laurb9/PanoController-Firmware/(threads)

Thread 1 (2016-03-05):

clean up pano interruption mode

laurb9, 2016-03-05:
- [x]  next/prev works well
- [x]  need a clean way to continue/end pano
  (right now OK ends and there is no way to continue)
- [x] should have a clearer display indicating which button does what

laurb9, 2016-03-06:
commit fe49507 partially implemented but still needs work

laurb9, 2016-03-07:
With IR remote, one can use OK to continue or cancel.

Closed 2016-03-07.

Thread 10 (2016-03-05):

Bluetooth 4.1 support

laurb9, 2016-03-05:
Same as (or depending on #8) but would need iOS app to control.

Major advantage would be that we can manage many pano profiles and pre-generate stitch files with photos already in position. The pano execution can be GPS-tagged and timestamped and used to identify the photo set once downloaded to the PC. Then we need a tool to preorder the images.

laurb9, 2016-04-03:
This could help: https://www.raywenderlich.com/85900/arduino-tutorial-integrating-bluetooth-le-ios-swift

laurb9, 2016-04-03:
Identified candidate board: HM-10 or HM-11, Bluetooth 4.0 LE
http://www.openhwdesign.com/ble-hm-10/
http://www.banggood.com/HM-10-Bluetooth-4_0-Module-Transparent-Serial-Port-p-967059.html

laurb9, 2016-07-24:
Another option is the Feather M0 BLE from Adafruit. Cortex M0 plus Bluetooth 4.1 LE in a pro-mini form factor.
https://learn.adafruit.com/adafruit-feather-m0-bluefruit-le/overview

Also Arduino 101 with Curie/Bluetooth, same price but large form factor.
Advantage: includes an IMU so one less board to connect to.
http://store-usa.arduino.cc/collections/products-atheart/products/abx00005

laurb9, 2016-08-08:
#59

laurb9, 2016-08-13:
Implemented a simple bluetooth control using the generic Adafruit Bluefruit iOS App
Connect to "Adafruit Bluefruit LE" -> Controller tab -> Control Pad module.
Directional arrows work, 1=OK, 3=CANCEL.

This is mostly a proof of concept and not all that useful yet, until all navigation can be moved to the app.

laurb9, 2017-08-14:
Work started on the [iOS PanoController App](https://github.com/laurb9/PanoController)
Will use Adafruit BLE modules because I have them already, although their interface is not compatible with the BLEPeripheral Arduino library.

This will replace the nrf24 radio controller unit that I added in #9

Closed 2017-09-11.

Thread 11 (2016-03-05):

Zero-motion shutter delay mode (gyro-based)

laurb9, 2016-03-05:
The MPU needs to be installed on camera platform, not base - need vertical flex wiring
Adds more complexity but has significant benefits:

Most important is "Shutter zero-motion wait mode": wait until platform is stable relative to the shutter and focal length selected, before activating shutter.

Closed 2016-04-01.

Thread 13 (2016-03-05):

PCB board

laurb9, 2016-03-05:
- design a smaller pano platform using the 0.5A steppers or servos, and integrated MPU into carrier.

Goals:
  - more portable: lighter, smaller)
  - thin profile: less nadir problems)
  - more battery life

Thread 14 (2016-03-05):

Investigate BDC (brushless DC) or servos instead of steppers

laurb9, 2016-03-05:
- with high reduction and gyro feedback, BDC motors can potentially be used
- needs different motor driver hardware and logic
- value is weight/size reduction

Thread 15 (2016-03-05):

Increase movement precision

laurb9, 2016-03-05:
1. Currently platform movement precision is limited by reduction ratio. We need more precision.
2. The FOV angles are stored as integers, which for longer lenses is imprecise (3 instead of 3.48, etc)

Switch the movement calculation code to floats entirely. Should be ok even with Arduino, it only adds <1K to the code.

Closed 2016-03-13.

Thread 17 (2016-03-05):

Support 16:9 and 1:1 modes

laurb9, 2016-03-05:
This can be simply an issue of calculating and adding the right FOV, or we could custom-define FOV via camera in the way that gigapan does (but is not great because it needs changing with zoom)

laurb9, 2017-10-02:
Going to cancel this, as more aspect ratios will be implemented in the App instead.

Closed 2017-10-02.

Thread 18 (2016-03-05):

Add batery voltage monitor

laurb9, 2016-03-05:
Add a simple divider to display input voltage.

laurb9, 2016-03-06:
Max voltage is 10V (the DRV8834 is 10.8V). So a divider like 47K:10K should be sufficient.

Closed 2016-03-07.

Thread 19 (2016-03-05):

Direct current control

laurb9, 2016-03-05:
Investigate ways to control Aref (and motor current) dynamically. It is currently controlled via a pot on the DRV board. Possibilities include
- break pot and use DAC + voltage divider
- use 1-2 digital pins with resistors to drain from divider and create a couple preset intermediary steps by adding resistors in parallel to GND branch of the pot.
- ?

laurb9, 2016-03-07:
Made some measurements using gigapan board, which seems to confirm this idea might make sense.
With motors on but not moving, the board draws 0.5A, but during movement this surges to 1.3A.

laurb9, 2017-10-02:
DRV8880 has current control (25, 50, 75 and 100%)

laurb9, 2017-10-02:
See #41

Closed 2017-10-02.

Thread 2 (2016-03-05):

Fix pano modes setup

laurb9, 2016-03-05:
Clean up pano options

- new pano currently needs horiz/vert FOV but configures at start (does not use preset)
- 360 pano needs vert FOV (it currently uses Vert FOV preset)
- repeat pano needs nothing (it reuses saved presets)
- maybe Horiz/Vert FOV are no longer needed in menu ?

laurb9, 2016-03-06:
Allowing horiz/vert as manual presets, they can be used with "repeat last".

Closed 2016-03-06.

Thread 5 (2016-03-05):

Auto Shutter mode (maybe never)

laurb9, 2016-03-05:
Listen to camera shutter noise (or vibration via accel). This could be useful to adapt to camera settings, but the following would need to be taken into account:

- both front and end shutters make noise
- electronic front shutter (only end shutter makes noise)
- camera profiles
- long exposure

Thread 6 (2016-03-05):

Smooth out motor movement

laurb9, 2016-03-05:
Starting the motor at full power causes it to miss step sometimes, depending on which intermediate position it was on. We should start slow and build up to max rpm, then slow back down to reduce shake.

This is a StepperDriver issue mostly likely.

laurb9, 2016-03-07:
Increasing current alleviates this problem somewhat. Horiz motor aref is now at 0.3V vs vertical at 0.2V

laurb9, 2017-06-27:
Can now use LINEAR_SPEED mode available in StepperDriver 1.1.0

Closed 2017-08-14.

Thread 7 (2016-03-05):

Remember vertical orientation

laurb9, 2016-03-05:
Vertical carrier orientation is relative to platform but as there is no end marker, calibration is not possible. Do not want to keep motors on all the time, but it may be what needs to be done.

CarriedBy6, 2022-07-15:
Might want to consider an absolute position sensor that way you don’t necessarily need end stops or homing procedures. [AS5048A](https://ams.com/as5048a) I added them to my axis and found it to be enough resolution (16,000+ positions at 360deg) even at 600mm.

laurb9, 2022-07-24:
This is a good idea, thanks. I didn't know these existed. A Hall effect or optical sensor is more cost effective if a 9-axis MPU is also installed, but this position sensor has potential.

Thread 9 (2016-03-05):

Add radio transmitter (opt)

laurb9, 2016-03-05:
- All of the display and input work could be offloaded to handheld radio remote device but the system is no longer self-contained.

laurb9, 2016-04-03:
I've identified an affordable RF board that could work: NRF24L01 2.4Ghz
http://arduino-info.wikispaces.com/Nrf24L01-2.4GHz-HowTo

Defragster, 2016-04-09:
Started at the top just seeing this - I'm using ESP8266 under Arduino with my Teensy, pretty effective - full web server support with it's own processor on par with the Teensy for under $5.

laurb9, 2016-04-09:
Some interactive features such as camera positioning would be adversely affected by WiFi latency. Others, like camera settings setup, would benefit from the nicer UI in web page. Unfortunately, I do need the interactive part more than the other, because with the camera on a pole it is hard to see what it's doing and intervene.

What I'm thinking here is move the menu and controls to a detachable remote piece. This increases the complexity and needs two microcontroller boards, but offloading the display work allows the motor controller side to do more.

laurb9, 2016-08-29:
Implemented a simple proof of concept which synchronizes inputs across two units via NRF24L01. For example, IR and Bluetooth remote inputs from one device are blindly sent to the unit containing the driver.

Syncing the display should be next.

laurb9, 2016-10-24:
Abandoned the above-mentioned proof of concept as it had to future path, and instead implemented #58 with a smart remote control unit with menus using the NRF24.

laurb9, 2016-10-24:
Bluetooth integration (#10) should be relatively easy to build on top of this.

Closed 2016-10-24.

Thread 20 (2016-03-06):

Standby Mode

laurb9, 2016-03-06:
Normal (motors off) power consumption is about 15mA.

Standby Mode should
- turn off motors (drive nSLEEP LOW)
- turn off display (this is impossible with current wiring) - maybe power display from a high current pin or ?
- put uC to sleep, wake up via button interrupt

Another way to achieve all this is to use one of these for a little extra cost:
https://www.pololu.com/product/2810 or https://www.pololu.com/product/2808 (Mini Pushbutton Power Switch)

laurb9, 2017-08-14:
About turning off motors see comment in #64

laurb9, 2017-10-02:
New versions might not need display at all. The MPU should be powered off though if not needed.
The app keeps all the info though, so maybe a power button is all we need.

Thread 22 (2016-03-06):

Add a start delay

laurb9, 2016-03-06:
Need a start delay so the platform doesn't try to move while we're still pushing the OK button. This of course would not be needed with the remote.

Closed 2016-03-06.

Thread 24 (2016-03-12):

Hangs when returning from pano setup via IR remote.

laurb9, 2016-03-12:
Canceling pano setup via IR remote ("0" button) goes back all the way to main menu then hangs.
The battery is not displayed.
No controls are responding.
Reset via battery disconnect is the only recovery option.

This may not be related to the remote per se, since canceling is not available on joystick.

laurb9, 2016-03-12:
Verified not related to remote by making positionCamera() return false (joystick OK cancels and hangs)

Closed 2016-03-13.

Thread 35 (2016-03-27):

Redesign pano operation display

laurb9, 2016-03-27:
It could be more like a camera settings page showing all important settings at a glance.
Switch to using graphics instead of text where needed.

laurb9, 2017-10-02:
low priority since the local display is now optional

laurb9, 2017-10-15:
not going to do this as all the status is going to be remote

Closed 2017-10-15.

Thread 41 (2016-04-01):

Lower current for maintaining position

laurb9, 2016-04-01:
When holding camera in place, use a lower current than when moving.

laurb9, 2016-09-14:
I was planning to do this by setting the current limiting vref using the DAC on Teensy, but the new [DRV8880](https://www.pololu.com/product/2971) driver board has a four step digital current control from 25% - 100% which means even an AVR can do it.

This board has a much better voltage range also: 6.5 to 45Vcc.

Thread 42 (2016-04-01):

Set pano dimensions by moving platform by hand

laurb9, 2016-04-01:
Record platform movement with motors off, instead of using motors.

Allow freestyle moving of camera/platform, record max top / bottom / left / right reached.

laurb9, 2017-10-02:
the gyro can be used to record the limits

Thread 44 (2016-04-01):

zero motion, shutter and bracketing/HDR

laurb9, 2016-04-01:
Shutter speed is not the real value when bracketing or using HDR. In these cases, the "shutter" covers all the shots in the bracket, so it will be a lot slower than reality. But zero motion is based on shutter among other things, so it will require the platform to be more steady than needed.

Defragster, 2016-04-09:
If the camera/lens does OIS that will help. The overexposed image can take some time. Might want the Teensy let you time the first (two) shots and then use that value for subsequent delays before going AUTO?

laurb9, 2016-04-09:
Well, the controller does not know what the camera does, it can trigger it but there's no feedback.

The problem here is with bracketing, you would do three shots for example, 1/50, 1/100, 1/25. So a "zero motion" based on 1/25s would suffice. But as my camera insists on wanting the shutter to stay pressed the entire sequence, I have to set the shutter value in the controller to something like 1/4s, which is a harder goal and the wait is longer for no good reason.

The solution is to separate the two settings, but I like simplicity, so I'm trying to think of a solution that does not add more variables to configure, or having to do intervals math in your head. I wish I had feedback from the camera, a test shot would give me everything I need.

laurb9, 2016-04-10:
This gives me an idea. There is single-shot bracketing which needs separate presses, and continuous bracket where the shutter needs to stay on the whole time. For now, I can do 3 shots per photo (there's an option in menu) at the longest interval. That solves the motion delay calculation problem to some extent.

laurb9, 2017-10-15:
The G-Code branch (#65) will address this by moving all the logic in the app which should handle the different bracket timings.

Closed 2017-10-15.

Thread 47 (2016-04-03):

Real Time Clock

laurb9, 2016-04-03:
Add an RTC.
Options are:
- a standalone DS3231 (works with any Arduino), or
- add a CR16 battery + crystal to the teensy board

Possible uses:
- display timestamp on pano info screen, so a screenshot can be used to match against photo sets.
- record panos taken in eeprom, and dump them via serial later.

Defragster, 2016-04-09:
ESP8266 to your phone would have NTP server access - except when you go out in the wilds without cell service - and turn off the ESP8266 to save battery.

I've put a couple crystals on my Teensy's and even wired one to a CR2032 once.

laurb9, 2016-04-09:
Auto setting time would be a nice feature, maybe not worth adding the power hungry ESP just for it, but the other capabilities are worth exploring.

The date doesn't have to that accurate, it only has to match the camera timestamp.
Mulling over a GPS unit. There are a few cheap ones out there, not sure how good.

laurb9, 2017-08-14:
Could add capability to sync time via BLE (after #10 is done)

laurb9, 2017-10-02:
This is less important now that the app keeps all the info.

Closed 2017-10-15.

Thread 48 (2016-04-03):

Pano log in EEPROM

laurb9, 2016-04-03:
Record information for each panoramas taken in EEPROM.
Dump the EEPROM over serial when connected to PC, for identifying the photo sets and settings easier.

Defragster, 2016-04-09:
The $8 PJRC prop shield has 8MB Flash and a HID software transfer app.

But an ESP8266 could save them to onboard 3MB SPIFFS and also post them in real time to the control web page to cut and paste to a file - or save the file for FTP transfer when done.

Recording the camera IMAGE number will make it easier to associate the notes - even if using a fresh flash card for each set.

laurb9, 2016-04-09:
Yes, recording more detail such as image numbers with timestamps for each photo is a good idea, thanks. Maybe elevation and azimuth also, if I add a compass could help with prealignment.

These aren't needed in real time though, since all the stitching happens at home base anyway.

laurb9, 2017-10-02:
May not need to be in EEPROM at all if it can be transferred to the app immediately.
Logging the position, timestamps and other known metadata for each photo is still useful.

Thread 49 (2016-04-03):

Backlash compensation

laurb9, 2016-04-03:
The gigapan unit's vertical backlash is significant at high zoom.
Add backlash compensation with predefined values in pano.h.

A nicer option is backlash autoadjust using the gyro.

Thread 50 (2016-04-09):

IR shutter remote

laurb9, 2016-04-09:
Add an IR transmitter to trigger the shutter.

# simpler: no more shutter cable to plug and unplug and expose opening to dust
# on A6000, IR remote can trigger a full bracketing sequence in one quick press, whereas the wired shutter needs to be held down the entire time otherwise

possible problems:
# strong sunlight issues ?

Defragster, 2016-04-09:
Or use an ESP8266 or similar.  Do data entry and control from a web page on your cell phone or tablet, buy more batteries.

laurb9, 2016-04-09:
This is to replace the teensy-to-camera shutter cable. The controller uses this to take a photo (or more) at each position, autonomously. Since most DSLRs have IR sensor, if I put the IR LED on the platform and use it to trigger the shots, I can get rid of a dangling (and possibly expensive) cable.

Defragster, 2016-04-09:
My camera like yours needs the press to hold for bracketing to complete - Does an IR interface deal with that or does I maintain a press?

laurb9, 2016-04-10:
At least for my camera, the IR remote needs a single quick press, which is the main reason I kind of want it. I've miscalculated the shutter timing a few times and I ended up having two instead of three pics in each frame.

Defragster, 2016-04-10:
I got a wired remote - not used it for bracketing.  So silly you select bracket - forget to hold the button - or forget to turn of bracketing - then until you do - alternate pictures are underexposed/overexposed ... or just right. If the IR can say 'takes pics' - not sure why the button doesn't. Getting camera feedback would close the loop

Thread 51 (2016-04-09):

Determine gear ratio using gyro

laurb9, 2016-04-09:
The gyro can be used to determine the gear ratio. This is probably not very useful unless somehow we can change gears easily.

laurb9, 2017-10-15:
I can't imagine a scenario where this would be useful

Closed 2017-10-15.

Thread 53 (2016-04-09):

Integrate MPU6050 DMP library or ?

laurb9, 2016-04-09:
Integrate Jeff Rowberg's i2clib and MPU6050 library (or something else?) for DMP access.
http://www.i2cdevlib.com/devices/mpu6050#source

This offloads DMP and calibration to the MPU and also gives access to MPU settings and position vectors.

Thread 54 (2016-04-11):

flash socket for shutter feedback ?

laurb9, 2016-04-11:
Investigate if it's possible to use the flash hotshoe for shutter feedback.

This allows figuring everything out from a test shot.

CarriedBy6, 2022-07-15:
I’m in the process of designing a gigapixel head myself. I have had luck creating a closed loop system using a Sony A7RIII and a Vello hot shoe adapter like this [Vello Adapter](https://www.bhphotovideo.com/c/product/1349065-REG/vello_hsa_smpcs_hsa_for_sony_multi.html) in order to detect when the exposure has finished and signal the head that it’s ok to move. It protects against a motion blurred pano having forgotten to match camera and head exposure duration in the menus. It’s also a big time saver for HDR. It gives you tighter timings instead of wasting time during shorter exposures having to account for your longest exposure in a set. I agree it would be great to also get the lens focal length settings automatically but my fix is a simple interrupt edge detection rather than decoding the Sony flash protocol.

laurb9, 2022-07-24:
This issue was indeed about the standard flash "switch", the other one you are referring to about decoding protocols is probably #55. Did you find that the duration matches the exposure time ?

Thread 56 (2016-07-24):

Release SPI0 pins (10,11,12,13)

laurb9, 2016-07-24:
Pins 10,11,12,13 on UNO are hardware SPI CS0, MOSI0, MISO0, SCK0.

See if we can move the microstep control (DRV_M0, DRV_M1) and motor enable (MOTORS_ON) elsewhere. 12 is defined as OLED_RESET but not actually connected.

Having builtin motor enabled feedback via LED is nice but should figure out another way.

Reference: https://www.arduino.cc/en/Reference/SPI

laurb9, 2016-08-08:
Canceling, due to #57 (UNO no longer supported)

Closed 2016-08-08.

Thread 57 (2016-07-24):

Stop supporting 8-bit AVR (AtMega328)

laurb9, 2016-07-24:
The effort and code complexity for continuing to support AtMega328 and friends are not worth it and could be better invested elsewhere.

I see no good reason not to move to 32bit platforms. Teensy LC is an Arduino-compatible 32bit ARM board close to the official Arduino Pro Mini price point.

Advantages
- get rid of PROGMEM hacks for split data/code memory, use const as intended
- more freedom to choose add-on boards (displays, etc)
- no more bumping into 2K memory limit (can revisit menu definition)
- get rid of 16-bit integer problems

Disadvantages
- some Pro Mini clones are cheap but I'm not trying to save pennies.

laurb9, 2016-08-01:
Current official target board is <a href="http://www.pjrc.com/store/teensylc.html">Teensy LC</a>: ARM Cortex-M0+ processor at 48 MHz, 62K Flash, 8K RAM

laurb9, 2016-08-08:
Done in v1.2

Closed 2016-08-08.

Thread 58 (2016-07-24):

Break code into platform module and remote control module

laurb9, 2016-07-24:
The display and controls are not usable while platform is rotating or is out of reach on a tall pole, which I think are common use cases.

Split the code and hardware into
- platform module (sensors, motor control, simple status display)
- remote control module (buttons, joystick, menus display)

The communication between the two can be serial (wired) or radio. The remote can be replaced by phone eventually. May need two boards otherwise.

laurb9, 2016-10-24:
Implemented in 2.0-beta: https://github.com/laurb9/pano-controller/releases/tag/v2.0-beta

Closed 2016-10-24.

Thread 59 (2016-08-07):

SAMD support (Adafruit Feather M0)

laurb9, 2016-08-07:
Support new Cortex M0 boards:

- Adafruit Feather M0 basic proto https://learn.adafruit.com/adafruit-feather-m0-basic-proto/
- Adafruit Feather M0 Bluefruit (with Bluetooth 4 LE add-on) https://learn.adafruit.com/adafruit-feather-m0-bluefruit-le/overview
- Arduino Zero https://www.adafruit.com/products/2843

- ATSAMD21G18 ARM Cortex M0
- 48 MHz
- 256K FLASH
- 32K of RAM
- **no EEPROM**
- 3.3V

pin allocation needs revisiting
This focuses on handling the M0 only. BLE integration in #10

laurb9, 2016-08-11:
Note: IRremote lib not supported yet in M0: https://github.com/z3t0/Arduino-IRremote/issues/274

laurb9, 2016-08-11:
All functionality other than IR remote working with the Adafruit Feather M0 Bluefruit board.

laurb9, 2016-08-11:
joystick probably needs to support a Cancel button in addition to OK.

laurb9, 2016-08-12:
Menu and joystick work, but motors are driven way too fast. Investigating.

Closed 2016-08-12.

Thread 61 (2016-10-16):

Single-board PanoController example no longer works

laurb9, 2016-10-16:
Since the split to Executor / Navigator, the single-unit PanoController no longer works.

Not sure if I want to keep it and fix, or just discontinue it. While the self-contained unit does have the set-it-and-forget-it advantage, I think remote control is the way to go.

Closed 2016-10-17.

Thread 62 (2016-10-24):

Precise positioning difficult for long zoom

laurb9, 2016-10-24:
(from field testing)

With 300mm + 1.4x, the head is moving fast over 4-5 cells so it's very hard to position accurately.

laurb9, 2016-10-29:
Equivalent focal length for APS-C: 630mm.

Closed 2017-08-14.

Thread 63 (2016-10-24):

Need higher shutter speeds

laurb9, 2016-10-24:
(from field testing)

Shutter speeds faster than 1/100 were initially assumed to be unnecessary, since camera responds to shutter command slower than that and the impact of faster times on total shooting time is negligible.

But shutter is also used in the zero-motion calculation (for acceptable angular velocity), and 1/100 is slow for long focal lengths (300-400-500 etc) so it causes unnecessarily long delays waiting for the platform to stabilize.

Closed 2016-10-29.

Thread 64 (2016-10-24):

Keep motors off if battery power below voltage threshold

laurb9, 2016-10-24:
Do not activate the ENABLE line if the Vin voltage drops below the minimum required for the drivers/motor combination to function, or the minimum acceptable battery voltage.

A threshold slightly above 5V would prevent the drivers being activated while powered from USB, if the step-down leaks current from Vcc to Vin.

Note: also add 10K pull-up on ENABLE to avoid activating the drivers on power-up until setup() got around to setting up the pin.

laurb9, 2017-08-14:
Just not activating ENABLE is probably fine. The other case, where Vin was good and then drops due to battery depletion, could be a problem. Turning off motors with a heavy lens can slam the lens into the pano unit, so maybe a controlled descent is better (but we don't know when to stop).

Thread 66 (2017-10-16):

G-Code loops

laurb9, 2017-10-16:
The currently implemented gcode is sufficient to execute the pano, but it has to be streamed from elsewhere (there isn't enough memory to load the entire program for very large panoramas).

The program could be shortened considerably by adding loop functionality.

Thread 73 (2020-09-27):

ESP32 support

laurb9, 2020-09-27:
Support ESP32 single or dual core with Bluetooth LE and WiFi.
https://docs.espressif.com/projects/esp-idf/en/latest/esp32/

laurb9, 2020-10-04:
Will use TTGO T-Display board (without display for now)

https://github.com/Xinyuan-LilyGO/TTGO-T-Display
