laurb9/PanoController-Firmware/(commit log)

2016-01-31 Add placeholders for basic components (camera, joystick, pano engine)
2016-02-04 Corrected current values (both motors are always on even if only one moves)
2016-02-04 Implement simple pano scan-and-shoot from current position.
2016-02-04 print debug output
2016-02-14 Add a menu definition that compiles under Arduino.
    Memory requirements make this a Teensy project now.
2016-02-14 Move both motors to start position after finishing the grid.
2016-02-14 Implement gear ration reduction for H/V motors. unsigned -> int to avoid unnecessary casts
    [pano.cpp, pano.h]
2016-02-15 Updated pin allocation (for Pro Mini)
2016-02-15 Add handling for the other Options subclasses, fix default value detection.
    [menu.cpp, menu.h]
2016-02-16 Fix selection not saving actually variables. Added active flag to support multi-level menus. Added control variables definition.
    [menu.cpp, menu.h]
2016-02-17 Implemented cancel via joystick button press.
2016-02-19 Wait for button to come back up to avoid jitter.
    [joystick.cpp]
2016-02-20 Set gear ratios to ones measured on Gigapan Epic 100.
2016-02-20 Shortened some descriptions to make room for current value display.
2016-02-20 Move more constant values and strings in flash.
    This probably breaks AVR build but we don't care since it is currently
    out of memory anyway.
2016-02-21 AVR PROGMEM fixes (FLASH reading macros)
    [menu.cpp, menu.h]
2016-02-21 Adjust menu to number of available rows.
    - Changed invoke_method macro to ternary operator to allow returning
    values from called methods.
    - Fixed teensy code.
    - AVR code uses 1955 bytes with 128x64, so display barely works.
    [menu.cpp, menu.h]
2016-02-21 Fix one flash read that was missed in commit b9f54b6
    [menu.cpp]
2016-02-21 Use a formula that works better for longer lenses.
2016-02-21 Moved individual execution loops out of main arduino loop for clarity.
2016-02-21 Fix shot count calculation.
    [pano.cpp]
2016-02-22 Use position-based movement calculation to avoid storing head location
    [pano.cpp, pano.h]
2016-02-22 Support gigapan motor (vertical move is reversed also)
    Changed speed limits so it works with under-driven 39BYG001 motor.
    [pano.cpp]
2016-02-22 Gigapan uses 0.3A with 1A motors. Go figure.
    But full-step doesn't seem to work, microstepping at 1:16 does but we
    have to go a lot slower.
    [pano.cpp]
2016-02-23 Fix range bug (range in one direction is half full scale)
    [joystick.h]
2016-02-24 Turn motors off after finishing pano.
2016-02-24 Take gear ratios into account sooner, to increase grid fit precision
2016-02-28 Fix UP/DOWN (was reversed compared to RIGHT/LEFT)
    [joystick.cpp]
2016-02-28 Implement basic aspect ratio setting (currently 3:2 and 2:3 only)
2016-02-28 "Start" now no longer needs confirmation
    [menu.cpp]
2016-02-28 Combined motorsOn/motorsOff into motorsEnable(on)
2016-03-02 Moved camera settings under Camera submenu.
2016-03-02 Use single pin to control both motors (active HIGH intended for nSLEEP)
2016-03-02 Reversed y-axis so up points up when connected according to labels
    [joystick.cpp]
2016-03-02 pin changes for prototype board
    Use ~SLEEP on 13 (LED) to activate both motors.
    Discontinue ~EN use.
    Install display reversed.
    Move focus/shutter to pins 0,1.
2016-03-03 Only display grid when it changes (it interrupts the motor move)
2016-03-03 Move around shortest path when resetting column position.
    This might cause a power cable to wrap around, so should eventually be
    configurable.
    [pano.cpp]
2016-03-06 Fix #3 360 pano now starts with setting vertical FOV. Fix #2.
    Added a pano info display.
    Implement OK to continue, UP to exit pano interruption mode (#1)
2016-03-06 #21 add progress bar and fix estimated time left.
    Previous time estimation did not take into account moving the platform
    which takes quite a bit of time.
    Fix grid estimates (before it did not show until both vert and horiz
    movement happened).
    [pano.cpp, pano.h]
2016-03-06 #1 interrupt mode fixes
    - display the arrows immediately
    - allow moving up/down
    - disabled pano continue (will need an intermediary menu perhaps)
    [pano.cpp, pano.h]
2016-03-06 Marked A0 for battery voltage monitor for #18
2016-03-07 #18 add battery status display during pano
    Also earmarked a few more pins for future devices.
2016-03-07 #8 added IR receiver with mini remote codes.
    Also implemented cancel behavior (remote only) for #1.
    Bugs: positioning camera with remote is too slow.
    [pano-controller.ino]
2016-03-07 #1 #8 can now interrupt pano with IR remote.
    Also moved the startup delay *after* the pano status was displayed, so
    it does not look like the button press had no effect.
2016-03-07 Cleanup
    Remove some Serial.print statements.
    Add displayArrows() in one place.
2016-03-07 Added breadboard and prototype photos. Yes it's real.
2016-03-08 Fix camera positioning with remote so it's usable.
    With remote, move 1 degree at fixed low rpm to prevent a jerky movement.
    With joystick, move 1/gear_ratio degree progressively faster.
    [pano-controller.ino]
2016-03-11 Display battery voltage at top right corner of menu.
2016-03-11 Updated current to 0.6A.
2016-03-12 Show panorama FOV when stopped instead of while moving.
    #defined constants for rpm
    add battery status to more screens
    expanded some over-shortened text (2x no longer cared about)
    [pano-controller.ino]
2016-03-12 #24 fix hanging when canceling camera positioning.
    [pano-controller.ino]
2016-03-12 Added Display class to support printf()
    Replaced groups of print() statements with printf()
    Use setTextCursor() instead of setCursor()
    [pano-controller.ino]
2016-03-12 Interface motors through Pano class rather than direct access.
    This is so the Pano object can remember home position when moving the
    platform.
2016-03-12 #15 switched from int to floats for head movement.
2016-03-12 #15, #6 slow down for shorter throws to reduce shake; other improvements
    Estimated time updated to include slow vs fast moves.
    Blink battery display when below 7V.
    [pano-controller.ino, pano.cpp, pano.h]
2016-03-12 Wrap teensy-specific code
2016-03-13 #15 display camera FOV with one decimal point.
2016-03-13 #15 bugfix - get*FOV() were returning truncated floats
    [camera.cpp]
2016-03-13 Fix moving too slow for wide lenses
    I don't know what I was thinking about with that /10.
    [pano-controller.ino]
2016-03-13 Replaced angle tables with formulas.
    [camera.cpp, camera.h]
2016-03-13 Added 640mm (400*1.6)
2016-03-13 Implement fixed shutter pulse of 1/10s.
    [camera.cpp, camera.h]
2016-03-13 Added processing wait and continuous bracket shutter mode.
    In Cont.Bkt mode the camera needs the shutter to stay pressed to take
    the full bracket.
    Processing mode is needed for in-camse multi-shot NR and HDR.
2016-03-17 Show correct grid size reflecting entire circle during 360 setup.
    [pano-controller.ino]
2016-03-20 Added wiring diagram and bill of materials.
2016-03-26 fix bug: take number of shots into account for time left
    and add steady_delay to each shot.
    [pano.cpp]
2016-03-26 Remove camera stabilization factor.
2016-03-27 #11 added accel/gyro MPU-6050 (GY-521 board) to schematic
2016-03-27 Update focal lengths to support APS and shutter speeds.
    Replace 70mm with 75mm (APS 50mm).
    Add 450mm (APS 300mm).
    Replace 640mm with 600mm (APS 400mm).
    Add 1/50 and 1/25 shutter speeds, removed 1/20.
    Add 0.25 post-procesing delay (A6000 has >0.1s reaction time to remote
    shutter)
2016-03-27 #36 prevent setting up panos wider than 360 or taller than 180.
    [pano-controller.ino]
2016-04-01 #37 fix row reset
    All the movement math should be float.
    [pano.cpp]
2016-04-02 Add zero-motion shutter delay and MPU-6050 board
2016-04-09 Fix progress bar alignment when shake not detected.
    [pano-controller.ino]
2016-07-25 Replaced generated menu with dynamically allocated definition.
    The json->cpp parser is no longer needed, menu can be defined in
    menu_definition.cpp now.
    EEPROM index allocation needs more work.
    [menus_definition.cpp]
2016-07-31 Allocate successive EEPROM addresses automatically.
    Hardcoding the index is prone to error.
    [menus_definition.cpp]
2016-08-05 skip RST pin initialization for display (not connected)
    [pano-controller.ino]
2016-08-08 Combine all input sources into AllHID #60
    Implemented an aggregator to avoid repeating read() / clear() for each
    input source individually.
    [menu.cpp, menu.h, pano-controller.ino]
2016-08-08 Moved joystick button interrupt handler inside joystick module.
2016-08-08 Updated notes (AVR not supported, wiring)
    Clarify AVR no longer supported.
    Added wiring notes for different boards.
    Moved motors under Hardware.
2016-08-10 Add fake EEPROM #59
    Cortex M0 has no EEPROM, and Adafruit's version does not emulate it like
    Teensyduino. So temporarily fake it to avoid compilation issues.
    [menu.cpp]
2016-08-10 Stub IRremote #59
    The library currently does not compile for this target, so we create a
    stub Remote class.
    See https://github.com/z3t0/Arduino-IRremote/issues/274
2016-08-10 #include <Arduino.h> for map(), min(), delay() #59
2016-08-10 Removed extra #includes that broke teensy build.
2016-08-10 All controls are now pointers; add Feather pin config section #59
    Control objects (camera, joystick, mpu, etc) are now instantiated in
    setup(), otherwise Feather crashes somewhere before setup().
    Added Feather M0 config section with some tentative pinouts.
    [pano-controller.ino]
2016-08-10 Moved pin configurations into arch-specific files #59
2016-08-11 Cast (int)analogRead() to avoid unsigned arithmetic #59
    [joystick.cpp]
2016-08-11 pin updates, upright screen, small fixes #59
    Moved battery checker to A1 (A0 can be a DAC)
    Do not rotate display upside-down.
    Fix battery display when moving between one and two digits.
    [config_feather_m0.h, pano-controller.ino]
2016-08-12 Added Adafruit Feather M0 to list of supported boards.
2016-08-13 Store settings on nRF51 NVRAM for Feather (#10,#59)
    Emulate EEPROM via BLE calls to NVRAM.
    add getMainMenu() to initialize Menu in setup(), as calling BLE from
    EEPROM before setup() will cause the device to hang.
2016-08-13 Added pin allocation worksheets for each arch
2016-08-13 Simplified pinout
    DIR is now shared
    M0,M1 are set up for 1:32
    Moved pin allocation (again) to README.md.
2016-08-21 Use ~ENABLE insted of ~SLEEP (reversed logic)
    The StepperDriver library handles enable()/disable() so Pano no longer
    has to keep track of the extra pin.
    Also, moved some other pins around.
    [config_feather_m0.h, config_teensy.h, pano-controller.ino, pano.cpp, pano.h]
2016-08-21 Detect if joystick is connected at startup, disable if not found.
    When joystick is not connected, floating X/Y inputs send random events
    which interfere with navigation.
    [joystick.cpp, joystick.h]
2016-08-22 BLE config
    Set LED mode to indicate Bluetooth traffic.
    Change device name to Pano Controller
2016-08-22 Documentation updates for BLE
    Removed outdated diagrams and photos.
    Added note about connecting ~SLEEP to Vcc.
    Added Bluefruit SPI Friend
2016-09-02 Broke out a Basic controller (no menus).
    Also moved all the various pano settings in a PanoSettings object
    instead of individual variables.
    [PanoController.ino, menu.h, menus_definition.cpp, pano.h]
2016-09-04 Send Settings object from Navigator to Executor via NRF24 #58
    This is currently a unidirectional, non-interactive send.
    The settings are immediately updated and displayed on the Executor unit.
2016-09-12 Bidirectional communication between Navigator and Executor units.
    Navigator sends settings and Executor sends state back.
    Also a simple protocol to position the head (needs more polishing).
    Communication is not reliable.
    Motors are not active for the entire positioning period before pano.
    For #58
2016-09-21 Added a motors_on state that is separate from menu setting motors_enable
    This is so positionCamera() can leave the motors on
2016-10-02 Keep shutter pins in high impedance mode when shutter not active.
    Only switch to OUTPUT mode to ground the pins, then switch back to
    INPUT.
    This way we can tell if the cable is connected (there should be some
    voltage on the line).
2016-10-16 Add Cancel button to Joystick.
2016-10-17 Fix single-unit PanoController so at least it compiles #61
    Chances are it also works.
    [PanoController.ino, config_feather_m0.h, config_teensy.h]
2016-10-21 Command-line compile any example for Teensy or Feather
2016-10-31 Free move in increments of 20% of FOV for #62
    Removed RPM control and associated joystick logic, since it requires
    knowledge of gear ratios.
    Possible options: Pano object translates platform rotation into internal
    RPM, or use acceleration.
2016-10-31 Poll joystick to avoid discontinous motion due to repeat interval.
    [PanoController.ino]
2016-10-31 hacky speed increase for continuous free movement
    Even for long zooms, we eventually switch to higher speed.
2016-11-02 Move pin setup to begin() to allow for static object initialization.
    The Arduino way seems to be:
    Class obj(...);
    void setup(){
    obj.begin(); // <-- this is where pin initialization happens
    }
2017-06-27 Smooth accelerated platform movement #6
    Requires StepperDriver 1.1.0
    Pano works well, but positioning needs more work as it now stops at each position.
    Pano timing might also need work.
    Accel/decel values need fine tuning.
2017-09-02 Remove code not needed for 2.1
    Navigator remote and old standalone PanoController, menus, nrf24 radio, all human input devices
2017-09-02 Replaced protocol with app_interface, implementing config, commands and status.
    This reuses the Config characteristic for multiple variables, causing some to get lost.
    [PanoController.ino, pano.cpp, pano.h]
2017-09-03 Receive config variables via UART also.
    The UART does internal buffering so it shouldn't overwrite previously sent data.
2017-09-03 binary->printable b/c AdafruitBLEUart is not binary safe
    Could not figure out why I could never set shuter=10ms... (\n is line terminator in uart)
2017-09-03 LED indicates BLE UART activity
2017-09-03 Fix FREE_MOVE command (params are 16bit integers now)
    [PanoController.ino]
2017-09-04 Turn off motors at startup
2017-09-10 Use multi-motor driver instead of controlling individual motors.
    Multi-axis simultaneous movement can shorten execution time somewhat.
    [PanoController.ino, pano.cpp, pano.h]
2017-09-10 Added unused async motor operation.
    This is currently useless because polling BLE takes 4000us and motor timing requires 50us while cruising.
2017-09-14 Use BLE DATA mode for binary mode, faster reading
    In DATA mode we can send binary over UART so we no longer need to encode.
    Also, ble.update() takes 4000+us while ble.available() for UART takes only 500us.
    This is still not fast enough to interlace with motor pulses though.
    [PanoController.ino]
2017-10-02 Leave event timing up to StepperDriver (works w/ 1.1.2)
2017-10-02 2.1.0 is the last version with pano logic in Arduino.
    Everything works fine except for the pre-positioning which is choppy but I'm not going to fix here.
2017-10-15 Add stepper status, motion and distance mode to M503
2017-10-16 Added println-equivalent back
2017-10-29 Small fixes, and send back "ok" after each command
    [PanoController.ino, gcode.cpp, gcode.h]
2017-11-09 New G-Code commands, updated status and config data.
    New acceleration (M202) and speed (M203) controls.
    M503 takes P parameter to control what to return.
    M116 Q~ now in °/s^2
    P~ is now milliseconds and S~ is seconds
2017-11-09 Don't run motors below 3V (safety check when running only on USB with external power disconnected)
2017-11-13 Read steps from Motors. Init GCode with MultiDriver instead of just motors.
2017-11-15 Fixed G92.1 to reset all coordinates to 0
    We need this to set the start/home position.
    [gcode.cpp, gcode.h]
2018-07-17 Use correct field separator in keywords.txt
    The Arduino IDE requires the use of a single true tab separator between the keyword name and identifier. When spaces are used rather than a true tab the keyword is not highlighted.
    Reference:
    https://github.com/arduino/Arduino/wiki/Arduino-IDE-1.5:-Library-specification#keywords
2019-02-09 Fixes for build with recent Arduino
    - ARDUINO_SAMD_FEATHER_M0 is now ADAFRUIT_FEATHER_M0
    - Removed eeprom.h out of the way (is no longer needed and has a name conflict anyway)
    [config.h]
2019-02-11 Power MPU via an output pin to be able to power on/off/reset easily.
    The MPU-6050 uses about 3mA which should be fine.
    [PanoController.ino, config_feather_m0.h, config_teensy.h]
2020-09-08 Add arduino-cli github-actions workflow
2020-09-08 Fix teensy platformio build
2020-09-08 changed job name Boards->Build
2020-09-11 Add configuration for PanoController V4 Platform using 28BYJ-48 motors
2020-09-27 Initial ESP32 support #73
2020-09-28 Move voltage divider to platforms, add rev string
2020-09-28 Add compat.h to handle missing macros in Arduino IDE
    Renamed REVISION to GIT_VERSION (there is already a REVISION somewhere)
    Add PANO_PLATFORM
    [PanoController.ino, compat.h, config.h, gcode.cpp]
2020-10-04 (bugfix) esp32: forgot to wrap read on ring buffer
    [ble_esp32.cpp]
2020-10-05 Update ESP32 wiring for TTGO T-Display board #73
    Reference: https://github.com/Xinyuan-LilyGO/TTGO-T-Display
2020-10-05 Use 17 instead of 12 for MPU VCC
    Upload flash fails when GY521 board VCC is connected to 12.
    [config_esp32.h]
